InanimateCarbonRod/BikeLight-Board/Transcode Report.txt

   ---- Transcoding 'C:\Users\Peanut\Documents\Bike light\SVN\Board\Rev10,v4\BikeLight_r10.top' ----   Mon Jul 28 09:52:33 2014

D10   --> D100
D11   --> D101
-----------------------------------------------------------------

   ---- Transcoding 'C:\Users\Peanut\Documents\Bike light\SVN\Board\Rev10,v4\BikeLight_r10.smt' ----   Mon Jul 28 09:53:25 2014

D10   --> D104
D11   --> D105
D12   --> D106
D16   --> D107
D17   --> D108
D18   --> D109
D19   --> D110
D20   --> D111
D21   --> D112
D22   --> D113
D23   --> D114
D24   --> D115
D25   --> D116
D26   --> D117
D27   --> D118
D28   --> D119
D29   --> D120
D30   --> D121
D31   --> D122
D32   --> D123
D33   --> D124
D34   --> D125
D35   --> D126
D36   --> D127
D37   --> D128
D38   --> D129
D39   --> D130
D40   --> D131
D41   --> D132
D42   --> D133
D43   --> D134
D44   --> D135
-----------------------------------------------------------------

   ---- Transcoding 'C:\Users\Peanut\Documents\Bike light\SVN\Board\Rev10,v4\BikeLight_r10.slk' ----   Mon Jul 28 09:54:14 2014

D10   --> D168
D11   --> D169
D12   --> D170
D13   --> D171
D15   --> D172
D16   --> D173
D17   --> D174
D18   --> D175
D19   --> D176
D20   --> D177
D21   --> D178
D22   --> D179
-----------------------------------------------------------------

   ---- Transcoding 'C:\Users\Peanut\Documents\Bike light\SVN\Board\Rev10,v4\BikeLight_r10.top' ----   Mon Jul 28 10:03:14 2014

D10   --> D100
D11   --> D101
-----------------------------------------------------------------

   ---- Transcoding 'C:\Users\Peanut\Documents\Bike light\SVN\Board\Rev10,v4\BikeLight_r10.smt' ----   Mon Jul 28 10:03:53 2014

D10   --> D104
D11   --> D105
D12   --> D106
D16   --> D107
D17   --> D108
D18   --> D109
D19   --> D110
D20   --> D111
D21   --> D112
D22   --> D113
D23   --> D114
D24   --> D115
D25   --> D116
D26   --> D117
D27   --> D118
D28   --> D119
D29   --> D120
D30   --> D121
D31   --> D122
D32   --> D123
D33   --> D124
D34   --> D125
D35   --> D126
D36   --> D127
D37   --> D128
D38   --> D129
D39   --> D130
D40   --> D131
D41   --> D132
D42   --> D133
D43   --> D134
D44   --> D135
-----------------------------------------------------------------

   ---- Transcoding 'C:\Users\Peanut\Documents\Bike light\SVN\Board\Rev10,v4\BikeLight_r10.slk' ----   Mon Jul 28 10:04:32 2014

D10   --> D168
D11   --> D169
D12   --> D170
D13   --> D171
D15   --> D172
D16   --> D173
D17   --> D174
D18   --> D175
D19   --> D176
D20   --> D177
D21   --> D178
-----------------------------------------------------------------

   ---- Transcoding 'C:\Users\Peanut\Documents\Bike light\SVN\Board\Rev10,v4\BikeLight_r10.bot' ----   Mon Jul 28 10:05:22 2014

D10   --> D179
D11   --> D180
D12   --> D181
D13   --> D182
D14   --> D183
D15   --> D184
D16   --> D185
D17   --> D186
D18   --> D187
D19   --> D188
D20   --> D189
D21   --> D190
D22   --> D191
D23   --> D192
D24   --> D193
D25   --> D194
D26   --> D195
D28   --> D196
D29   --> D197
D30   --> D198
D31   --> D199
D32   --> D200
D33   --> D201
D34   --> D202
D35   --> D203
D36   --> D204
D37   --> D205
D38   --> D206
D39   --> D207
D40   --> D208
D41   --> D209
D42   --> D210
D43   --> D211
-----------------------------------------------------------------
