InanimateCarbonRod/BikeLight-Board/BikeLight_r10_BOM.xls

Partlist, Open POV light r10
Part | Value | Device | Package | Description | Populate Y/N | Qty | Newark PN | Newark 100 qty price (ea) | Total price
C1, C2, C15, C23, C32-C34 | 0.1 | uF | C-USC0402 | C0402 | Y | 7 | 68R4688 | 0.0027 | 0.0189
C3-C12, C14, C24, C25 | 10 | uF | C-USC0805 | C0805 | Y | 13 | 68R4928 | 0.025 | 0.325
C13 | 2.2 | uF | C-USC0805K | C0805K | Y | 1 | 77M8471 | 0.03 | 0.03
C16, C17, C27, C29 | 1 | uF | C-USC0402 | C0402 | Y | 4 | 68R4627 | 0.006 | 0.024
C18 | 47 | uF | CPOL-USCT6032 | CT6032 | Y | 1 | 09K6654 | 0.341 | 0.341
C19, C20 | 20 | pF | CAP0402-CAP | 0402-CAP | N | 0 |  |  | 0
C21, C26 | 100 | pF | C-USC0805K | C0805K | N | 0 |  |  | 0
C22 | 56 | nF | CAP0402-CAP | 0402-CAP | N | 0 |  |  | 0
C28, C30 | 0.01 | uF | CAP0402-CAP | 0402-CAP | N | 0 |  |  | 0
C31 | 0.01 | uF | CAP0402-CAP | 0402-CAP | Y | 1 | 68R4658 | 0.002 | 0.002
D1-D3 | DZ2S068M0L | DIODE SOD523 | SOD523 | DIODE | Y | 3 | 56W3805 | 0.018 | 0.054
D4 | BB141 | BB141 | SOD523 | Capacity | N | 0 | 75R5258 | 0.055 | 0
G1 | AA | AA | AA_BATTERY | AA | Y | 1 | 16F1089 | 0.58 | 0.58
JP1 | FTDI | Basic | ARDUINO_SERIAL_PROGRAMPTH | 1X06 | N | 0 |  |  | 0
JP2 | M03X2POGO_PINS | 2X3_POGO | 2x3 | .1" | N | 0 |  |  | 0
L1 | 6.2 | uH | INDUCTORSRU1038 | CDRH52D | Y | 1 | 83T0246 | 0.175 | 0.175
LED1-LED10 | CLV1A | TOPLED-3 | P-LCC-4-3 | OSRAM | Y | 10 | 73P9856 | 0.476 | 4.76
Q1 | 8/16/20MHz | RESONATORSMD | RESONATOR-SMD | Resonator | Y | 1 | 11N7357 | 0.515 | 0.515
Q3 | NX5032GA | 8MHZ | AT-W | FC-12M | N | 0 |  |  | 0
R2, R11 | 2.2k | R-US_R0402 | R0402 | RESISTOR | N | 2 | 67R9980 | 0.002 | 0.004
R4, R5 | 390k | R-US_R0402 | R0402 | RESISTOR | Y | 2 | 53W8365 | 0.004 | 0.008
R6 | 1.6 | M | R-US_R0805 | R0805 | N | 0 |  |  | 0
R7 | 1M | R-US_R0805 | R0805 | RESISTOR | Y | 1 | 58K4696 | 0.007 | 0.007
R8 | 10k | R-US_R0402 | R0402 | RESISTOR | Y | 1 | 67R9964 | 0.008 | 0.008
R9 | 0 | R-US_R0805 | R0805 | RESISTOR | Y | 1 | 68R0252 | 0.012 | 0.012
R10 | 178k | R-US_R0805 | R0805 | RESISTOR | N | 0 |  |  | 0
S1 | CT10-1530-G1 | REED-SWITCH-CT10-1530-G1 | CT10-G1 | Reed | Y | 1 | 98H3468 | 0.615 | 0.615
S2 | Reset | TAC_SWITCHSMD | TACTILE_SWITCH_SMD | Momentary | Y | 1 | 15N4497 | 0.254 | 0.254
U2 | TPS61026_DRC_10 | TPS61026_DRC_10 | DRC10_2P4X1P65 | http://www.ti.com/lit/gpn/TPS61026 | Y | 1 | 24M8538 | 1.84 | 1.84
U3, U4 | TLC5940_PWP_28 | TLC5940_PWP_28 | PWP28_6P17X2P4 | http://www.ti.com/lit/gpn/TLC5940 | Y | 2 | 08K4866 | 1.86 | 3.72
U5 | ADXL337BCPZ-RL | ADXL337BCPZ-RL | CP_16_28 |  | Y | 1 | 94T2513 | 3.08 | 3.08
U6 | LP5951MF-3.3 | LP5951MF-3.3 | SOT95P285X120-5N | Low-Dropout | Y | 1 | 13M2085 | 3.06 | 3.06
U7 | CP2104 | CP2104 | QFN24-4X4 | Single-Chip | Y | 1 | Digi 336-2008-5-ND | 1.328 | 1.328
U8 | LDC1000 | LDC1000 | WSON-16 |  | N | 0 |  |  | 0
X1 | OUT | 22-23-2031 | 22-23-2031 | .100" | N | 0 |  |  | 0
X2 | IN | 22-23-2031 | 22-23-2031 | .100" | N | 0 |  |  | 0
X3 | 48037-1000 | USB-A003 | USB-A_PLUG | USB | Y | 1 | 01J8375 | 0.656 | 0.656
X4 | 1.27X5PTH | 1.27X5PTH | 1X04-1.27MM |  | N | 0 |  |  | 0
 |  |  |  |  |  |  |  |  | 23.5169
 |  |  |  |  |  |  |  |  | *TPS61206 has a $20 freight charge!
