InanimateCarbonRod/BikeLight-Board/BikeLight_r10.brd

## EAGLE design BikeLight_r10.brd (2015-07-08)

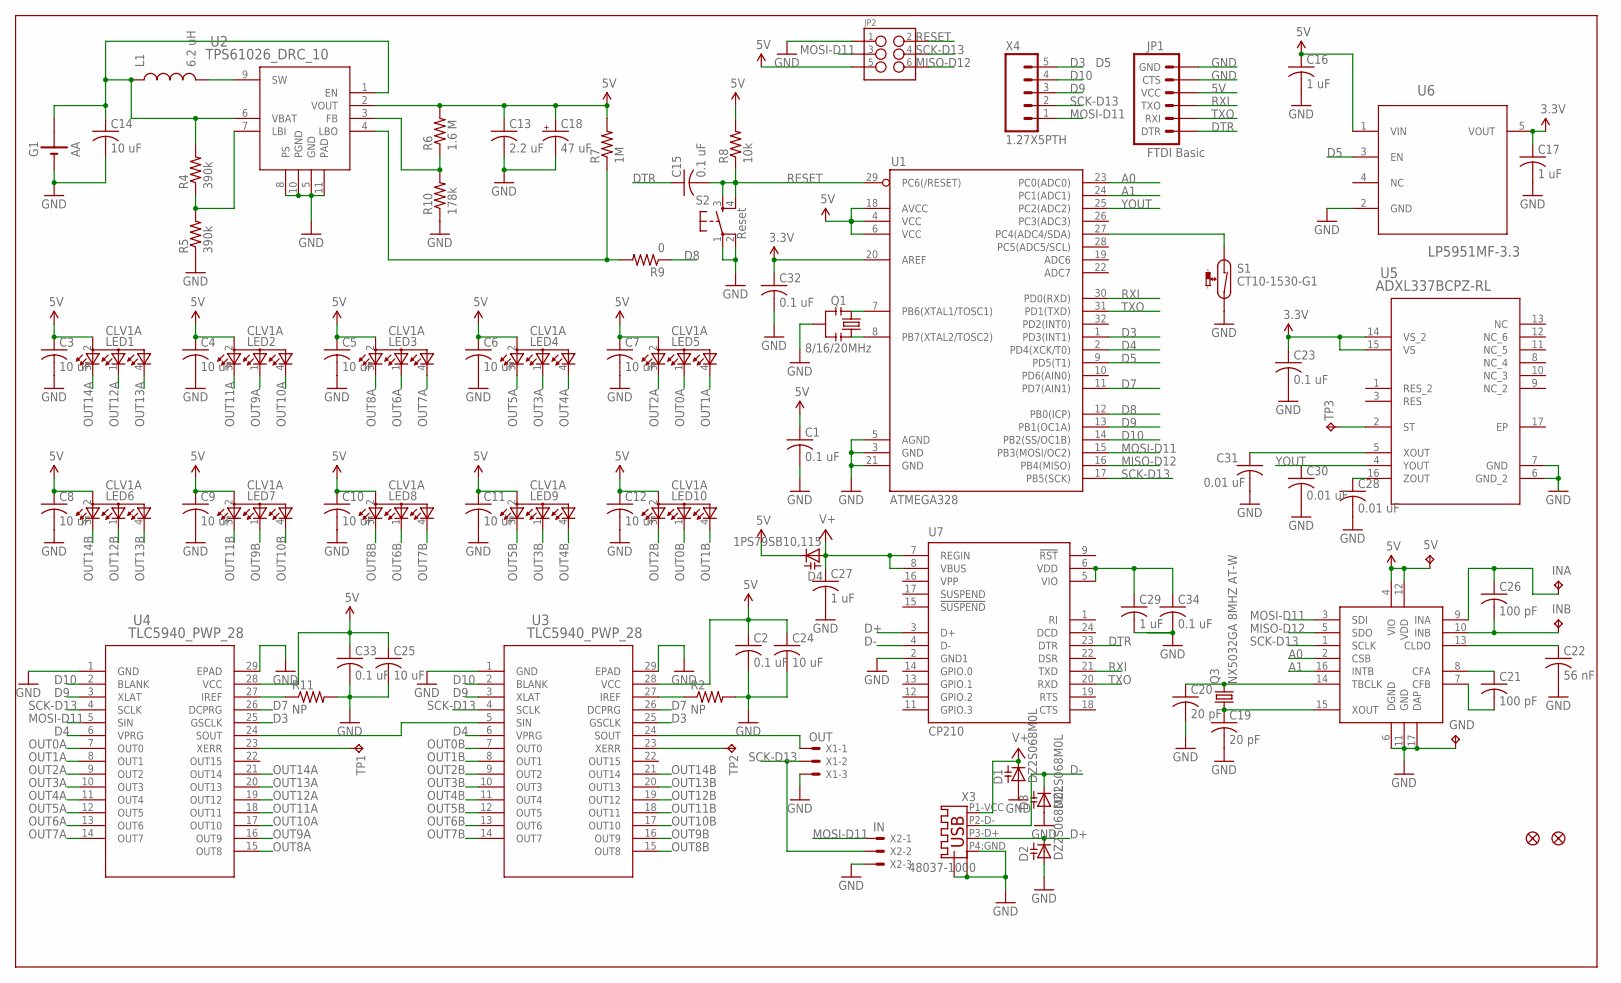
[picture p1: schematic BikeLight_r10.sch]

Parts:
5V: TPPAD1-13; P1-13
C1, C2, C15, C23, C32, C33, C34: 0.1 uF; C0402
C3, C4, C5, C6, C7, C8, C9, C10, C11, C12: 10 uF; C0805
C13: 2.2 uF; C0805K
C14, C24, C25: 10 uF; C0805K
C16, C17, C27, C29: 1 uF; C0402
C18: 47 uF; CT6032
C19, C20: 20 pF; C0402
C21, C26: 100 pF; C0805K
C22: 56 nF; C0402
C28, C30, C31: 0.01 uF; C0402
D1, D2, D3: DZ2S068M0L; SOD523
D4: 1PS79SB10,115; SOD523
G1: AA; AA_BATTERY
GND: TPPAD1-13; P1-13
INA: TPPAD1-13; P1-13
INB: TPPAD1-13; P1-13
JP1: FTDI Basic; 1X06
JP2: M03X2POGO_PINS; 2X3_POGO
L1: 6.2 uH; CDRH52D
LED1, LED2, LED3, LED4, LED5, LED6, LED7, LED8, LED9, LED10: CLV1A; P-LCC-4-3
Q1: 8/16/20MHz; RESONATOR-SMD
Q3: NX5032GA 8MHZ AT-W; FC-12M
R2, R11: NP; R0402
R4, R5: 390k; R0402
R6: 1.6 M; R0805
R7: 1M; R0805
R8: 10k; R0402
R9: 0; R0805
R10: 178k; R0805
S1: CT10-1530-G1; CT10-G1
S2: Reset; TACTILE_SWITCH_SMD
TP1, TP2, TP3: TPB1,27; B1,27
U1: ATMEGA328; TQFP32-08
U2: TPS61026_DRC_10; DRC10_2P4X1P65
U3, U4: TLC5940_PWP_28; PWP28_6P17X2P4
U5: ADXL337BCPZ-RL; CP_16_28
U6: LP5951MF-3.3; SOT95P285X120-5N
U7: CP210; QFN24-4X4
U8: LDC1000; WSON-16
U$2, U$4: FIDUCIAL1X2; FIDUCIAL-1X2
X1: OUT; 22-23-2031
X2: IN; 22-23-2031
X3: 48037-1000; USB-A_PLUG
X4: 1.27X5PTH; 1X04-1.27MM

Connections:
3.3V: C17.1, C23.1, C32.1, U1.20 (AREF), U5.14 (VS_2), U5.15 (VS), U6.5 (VOUT)
5V: 5V.TP, C1.1, C2.1, C3.1, C4.1, C5.1, C6.1, C7.1, C8.1, C9.1, C10.1, C11.1, C12.1, C13.1, C16.1, C18.+, C24.1, C25.1, C33.1, D4.C, JP1.4 (VCC), JP2.P$5 (5), LED1.2 (A2), LED2.2 (A2), LED3.2 (A2), LED4.2 (A2), LED5.2 (A2), LED6.2 (A2), LED7.2 (A2), LED8.2 (A2), LED9.2 (A2), LED10.2 (A2), R6.2, R7.2, R8.2, U1.4 (VCC), U1.6 (VCC), U1.18 (AVCC), U2.2 (VOUT), U3.28 (VCC), U4.28 (VCC), U6.1 (VIN), U8.4 (VIO), U8.12 (VDD)
A0: U1.23 (PC0(ADC0)), U8.2 (CSB)
A1: U1.24 (PC1(ADC1)), U8.16 (INTB)
D3: U1.1 (PD3(INT1)), U3.25 (GSCLK), U4.25 (GSCLK), X4.5
D4: U1.2 (PD4(XCK/T0)), U3.6 (VPRG), U4.6 (VPRG)
D5: U1.9 (PD5(T1)), U6.3 (EN)
D7: U1.11 (PD7(AIN1)), U3.26 (DCPRG), U4.26 (DCPRG)
D8: R9.1, U1.12 (PB0(ICP))
D9: U1.13 (PB1(OC1A)), U3.3 (XLAT), U4.3 (XLAT), X4.3
D10: U1.14 (PB2(SS/OC1B)), U3.2 (BLANK), U4.2 (BLANK), X4.4
D+: D2.C, U7.3 (D+), X3.P3-D+ (3)
D-: D3.C, U7.4 (D-), X3.P2-D- (2)
DTR: C15.1, JP1.1 (DTR), U7.23 (DTR)
GND: C1.2, C2.2, C3.2, C4.2, C5.2, C6.2, C7.2, C8.2, C9.2, C10.2, C11.2, C12.2, C13.2, C14.2, C16.2, C17.2, C18.-, C19.2, C20.2, C22.2, C23.2, C24.2, C25.2, C27.2, C28.2, C29.2, C30.2, C31.2, C32.2, C33.2, C34.2, D1.A, D2.A, D3.A, G1.P$2- (-), GND.TP, JP1.5 (CTS), JP1.6 (GND), JP2.P$1 (1), Q1.2, R2.2, R5.1, R10.1, R11.2, S1.2, S2.1, S2.2, U1.3 (GND), U1.5 (AGND), U1.21 (GND), U2.5 (GND), U2.8 (PS), U2.10 (PGND), U2.11 (PAD), U3.1 (GND), U3.29 (EPAD), U4.1 (GND), U4.29 (EPAD), U5.6 (GND_2), U5.7 (GND), U6.2 (GND), U7.2 (GND1), U8.6 (DGND), U8.11 (GND), U8.17 (DAP), X1.3, X2.3, X3.P4:GND (4), X3.P$5 (SHLD1), X3.P$6 (SHLD2)
MISO-D12: JP2.P$6 (6), U1.16 (PB4(MISO)), U8.5 (SDO)
MOSI-D11: JP2.P$3 (3), U1.15 (PB3(MOSI/OC2)), U4.5 (SIN), U8.3 (SDI), X2.1, X4.1
unnamed: Q1.1, U1.8 (PB7(XTAL2/TOSC2))
unnamed: Q1.3, U1.7 (PB6(XTAL1/TOSC1))
unnamed: U3.5 (SIN), U4.24 (SOUT)
unnamed: U3.24 (SOUT), X1.1
unnamed: TP1.TP, U4.23 (XERR)
unnamed: TP2.TP, U3.23 (XERR)
unnamed: R4.1, R5.2, U2.7 (LBI)
unnamed: R6.1, R10.2, U2.3 (FB)
unnamed: R2.1, U3.27 (IREF)
unnamed: C14.1, G1.P$1+ (+), L1.1, R4.2, U2.1 (EN), U2.6 (VBAT)
unnamed: L1.2, U2.9 (SW)
unnamed: R7.1, R9.2, U2.4 (LBO)
unnamed: TP3.TP, U5.2 (ST)
unnamed: C20.1, Q3.2, U8.14 (TBCLK)
unnamed: C19.1, Q3.1, U8.15 (XOUT)
unnamed: R11.1, U4.27 (IREF)
unnamed: C21.1, U8.8 (CFA)
unnamed: C21.2, U8.7 (CFB)
unnamed: C26.2, INB.TP, U8.10 (INB)
unnamed: C22.1, U8.13 (CLDO)
unnamed: C29.1, C34.1, U7.5 (VIO), U7.6 (VDD)
unnamed: C26.1, INA.TP, U8.9 (INA)
unnamed: C31.1, U5.5 (XOUT)
unnamed: S1.1, U1.27 (PC4(ADC4/SDA))
OUT0A: LED5.1 (CBLUE), U4.7 (OUT0)
OUT0B: LED10.1 (CBLUE), U3.7 (OUT0)
OUT1A: LED5.4 (CGREEN), U4.8 (OUT1)
OUT1B: LED10.4 (CGREEN), U3.8 (OUT1)
OUT2A: LED5.3 (CRED), U4.9 (OUT2)
OUT2B: LED10.3 (CRED), U3.9 (OUT2)
OUT3A: LED4.1 (CBLUE), U4.10 (OUT3)
OUT3B: LED9.1 (CBLUE), U3.10 (OUT3)
OUT4A: LED4.4 (CGREEN), U4.11 (OUT4)
OUT4B: LED9.4 (CGREEN), U3.11 (OUT4)
OUT5A: LED4.3 (CRED), U4.12 (OUT5)
OUT5B: LED9.3 (CRED), U3.12 (OUT5)
OUT6A: LED3.1 (CBLUE), U4.13 (OUT6)
OUT6B: LED8.1 (CBLUE), U3.13 (OUT6)
OUT7A: LED3.4 (CGREEN), U4.14 (OUT7)
OUT7B: LED8.4 (CGREEN), U3.14 (OUT7)
OUT8A: LED3.3 (CRED), U4.15 (OUT8)
OUT8B: LED8.3 (CRED), U3.15 (OUT8)
OUT9A: LED2.1 (CBLUE), U4.16 (OUT9)
OUT9B: LED7.1 (CBLUE), U3.16 (OUT9)
OUT10A: LED2.4 (CGREEN), U4.17 (OUT10)
OUT10B: LED7.4 (CGREEN), U3.17 (OUT10)
OUT11A: LED2.3 (CRED), U4.18 (OUT11)
OUT11B: LED7.3 (CRED), U3.18 (OUT11)
OUT12A: LED1.1 (CBLUE), U4.19 (OUT12)
OUT12B: LED6.1 (CBLUE), U3.19 (OUT12)
OUT13A: LED1.4 (CGREEN), U4.20 (OUT13)
OUT13B: LED6.4 (CGREEN), U3.20 (OUT13)
OUT14A: LED1.3 (CRED), U4.21 (OUT14)
OUT14B: LED6.3 (CRED), U3.21 (OUT14)
RESET: C15.2, JP2.P$2 (2), R8.1, S2.3, S2.4, U1.29 (PC6(/RESET))
RXI: JP1.3 (TXO), U1.30 (PD0(RXD)), U7.21 (TXD)
SCK-D13: JP2.P$4 (4), U1.17 (PB5(SCK)), U3.4 (SCLK), U4.4 (SCLK), U8.1 (SCLK), X1.2, X2.2, X4.2
TXO: JP1.2 (RXI), U1.31 (PD1(TXD)), U7.20 (RXD)
V+: C27.1, D1.C, D4.A, U7.7 (REGIN), U7.8 (VBUS), X3.P1-VCC (1)
YOUT: C30.1, U1.25 (PC2(ADC2)), U5.4 (YOUT)
ZOUT: C28.1, U5.16 (ZOUT)

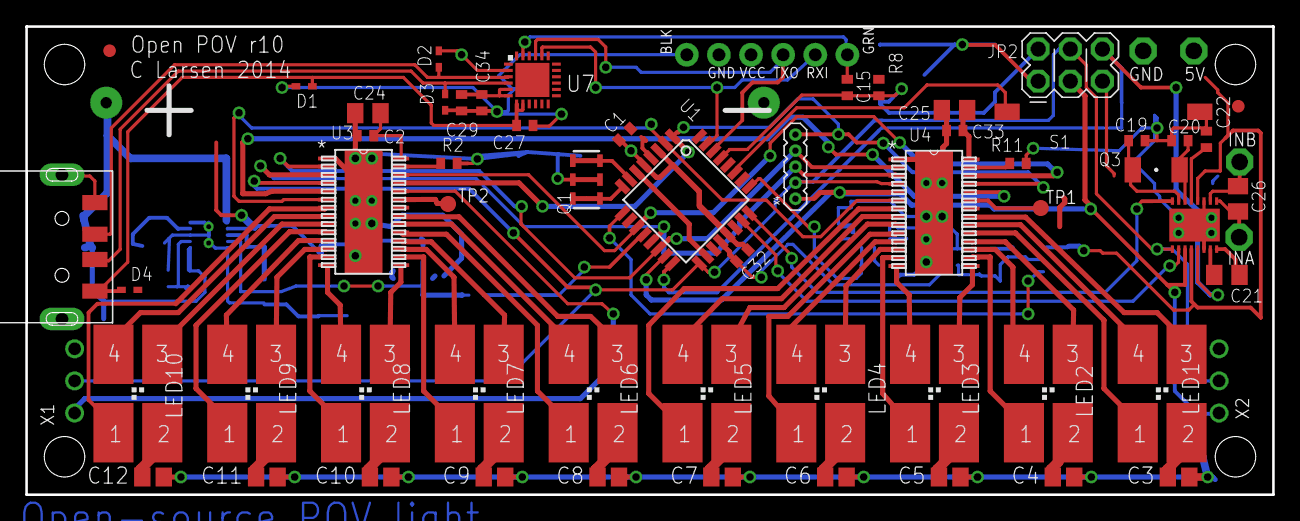
[picture p2: board BikeLight_r10.brd from above]

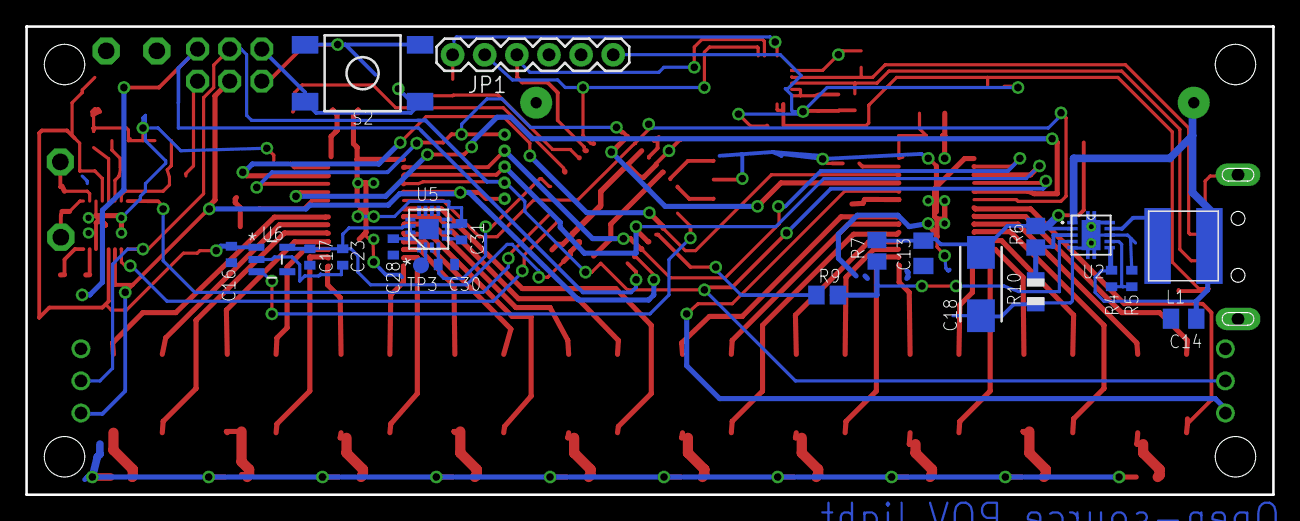
[picture p3: board BikeLight_r10.brd from below]

Board: 2 copper layers, 98.6 x 37.0 mm, 86 parts (22 on the bottom side), 78 nets.
