InanimateCarbonRod/BikeLight-Board/(notices)

Notices in the files:
BikeLight_r10.brd:
Released under the Creative Commons Attribution Share-Alike 3.0 License
http://creativecommons.org/licenses/by-sa/3.0
parts and their libraries:
Inductor-SumidaCDRH5D28: Licensing: CC v3.0 Share-Alike You are welcome to use this library for commercial purposes.
